overallcoma/project-grayskull/Hardware/24CHv1.0/24_channel_esp32_energy_meter.kicad_sch

## KiCad design Hardware/24CHv1.0/24_channel_esp32_energy_meter.kicad_sch (2023-05-05)

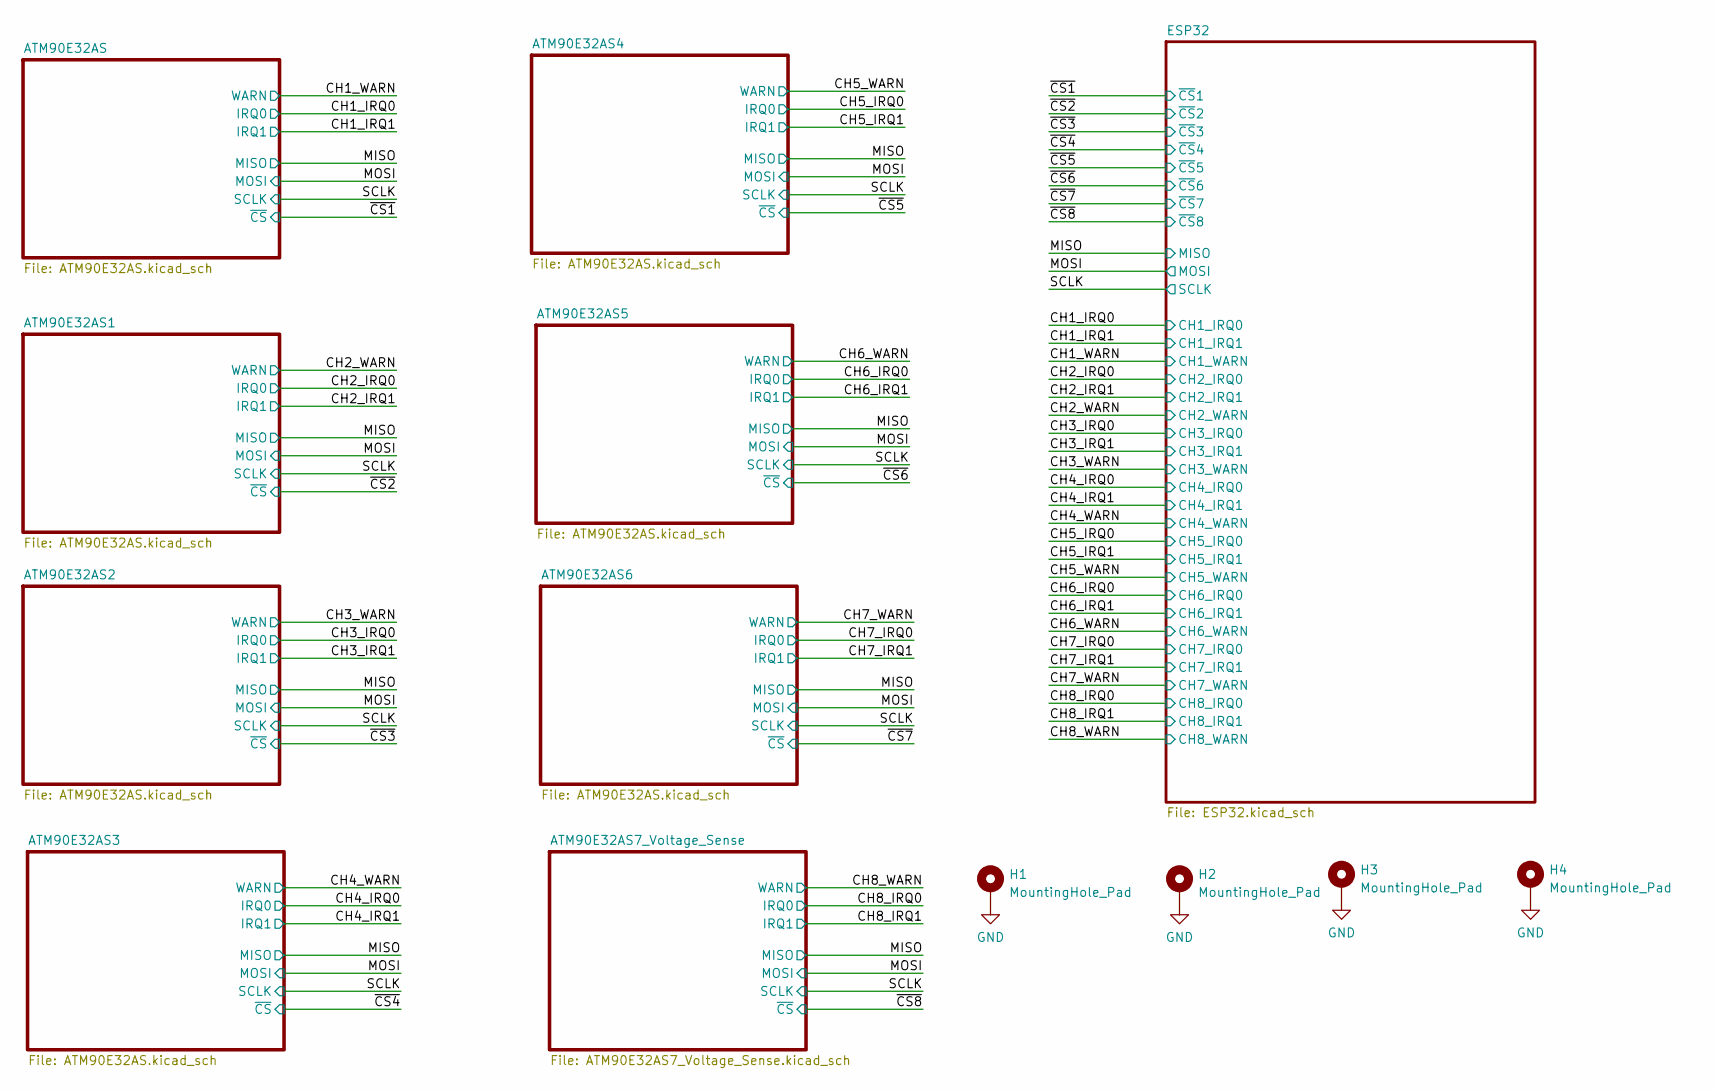
[picture p1: schematic 24_channel_esp32_energy_meter.kicad_sch]

Parts:
H1, H2, H3, H4: MountingHole_Pad; MountingHole_3.2mm_M3_Pad_Via

Connections:
GND: H1.1, H2.1, H3.1, H4.1
