overallcoma/project-grayskull/Hardware/24CHv1.0/ATM90E32AS7_Voltage_Sense.kicad_sch

## KiCad design Hardware/24CHv1.0/ATM90E32AS7_Voltage_Sense.kicad_sch (2023-05-05)

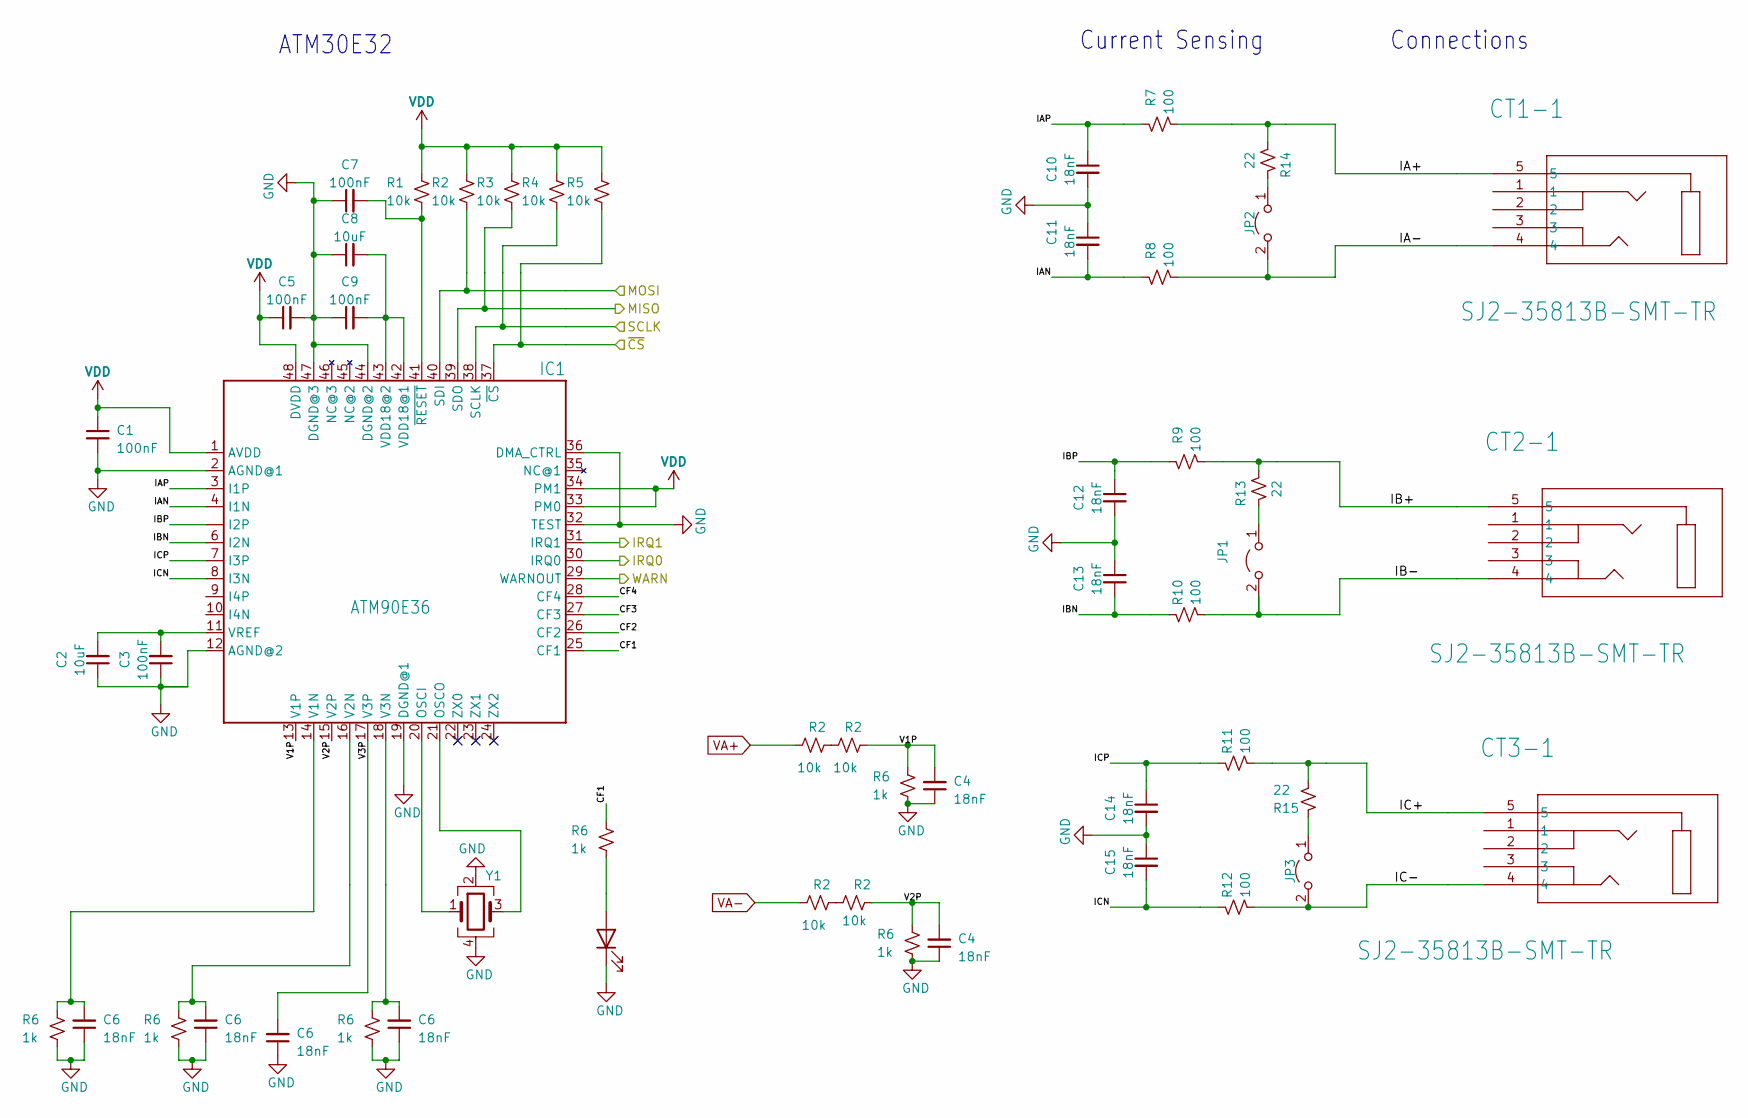
[picture p2: schematic ATM90E32AS7_Voltage_Sense.kicad_sch]

Parts:
C1, C3, C5, C7, C9: 100nF; C_0603_1608Metric; Manufacturer P/N CL10B104KB8NNWC
C2, C8: 10uF; C_0805_2012Metric; Manufacturer P/N CL21A106KAYNNNG
C4, C6, C10, C11, C12, C13, C14, C15: 18nF; C_0603_1608Metric; Manufacturer P/N 0603B183K500CT
CF1: BLU; LED_0603_1608Metric; Manufacturer P/N B1931NB--20C007614U1930
CT1-1, CT2-1, CT3-1: SJ2-35813B-SMT-TR; STX-3790-5N_KYC; Manufacturer P/N STX-3790-5N
IC1: ATM90E36; LQFP-48_7x7mm_P0.5mm; Manufacturer P/N ATM90E36A-AU-Y
JP1, JP2, JP3: Jumper_2_Open; SolderJumper-2_P1.3mm_Open_RoundedPad1.0x1.5mm
R1, R2, R3, R4, R5: 10k; R_0603_1608Metric; Manufacturer P/N RMCF0603FT10K0
R6: 1k; R_0603_1608Metric; Manufacturer P/N RMCF0603JJ1K00
R7, R8, R9, R10, R11, R12: 100; R_0603_1608Metric; Manufacturer P/N WR06X1000FTL
R13, R14, R15: 22; R_2512_6332Metric; Manufacturer P/N CR2512-JW-220ELF
Y1: Crystal_GND24; Crystal_SMD_3225-4Pin_3.2x2.5mm; Manufacturer P/N S3216384102040

Connections:
CF1: IC1.25 (CF1), R6.1
CF2: IC1.26 (CF2)
CF3: IC1.27 (CF3)
CF4: IC1.28 (CF4)
GND: C1.2, C2.1, C3.1, C4.1, C5.2, C6.1, C7.1, C8.1, C9.1, C10.2, C11.1, C12.2, C13.1, C14.2, C15.1, CF1.1 (K), IC1.2 (AGND@1), IC1.12 (AGND@2), IC1.19 (DGND@1), IC1.32 (TEST), IC1.36 (DMA_CTRL), IC1.44 (DGND@2), IC1.47 (DGND@3), R6.2, Y1.2, Y1.4
IA+: CT1-1.5, R7.2, R14.2
IA-: CT1-1.4, JP2.2 (B), R8.2
IAN: C11.2, IC1.4 (I1N), R8.1
IAP: C10.1, IC1.3 (I1P), R7.1
IB+: CT2-1.5, R9.2, R13.2
IB-: CT2-1.4, JP1.2 (B), R10.2
IBN: C13.2, IC1.6 (I2N), R10.1
IBP: C12.1, IC1.5 (I2P), R9.1
IC+: CT3-1.5, R11.2, R15.2
IC-: CT3-1.4, JP3.2 (B), R12.2
ICN: C15.2, IC1.8 (I3N), R12.1
ICP: C14.1, IC1.7 (I3P), R11.1
IRQ0: IC1.30 (IRQ0)
IRQ1: IC1.31 (IRQ1)
MISO: IC1.39 (SDO), R3.2
MOSI: IC1.40 (SDI), R2.2
unnamed: C2.2, C3.2, IC1.11 (VREF)
unnamed: C6.2, IC1.14 (V1N), IC1.16 (V2N), IC1.18 (V3N), R6.1
unnamed: C7.2, IC1.41 (~RESET), R1.2
unnamed: C8.2, C9.2, IC1.42 (VDD18@1), IC1.43 (VDD18@2)
unnamed: CF1.2 (A), R6.2
unnamed: IC1.20 (OSCI), Y1.1
unnamed: IC1.21 (OSCO), Y1.3
unnamed: JP1.1 (A), R13.1
unnamed: JP2.1 (A), R14.1
unnamed: JP3.1 (A), R15.1
unnamed: R2.1, R2.2
SCLK: IC1.38 (SCLK), R4.2
V1P: C4.2, IC1.13 (V1P), R2.2, R6.1
V2P: C4.2, IC1.15 (V2P), R2.2, R6.1
V3P: C6.2, IC1.17 (V3P)
VA+: R2.1
VA-: R2.1
VDD: C1.1, C5.1, IC1.1 (AVDD), IC1.33 (PM0), IC1.34 (PM1), IC1.48 (DVDD), R1.1, R2.1, R3.1, R4.1, R5.1
WARN: IC1.29 (WARNOUT)
~CS: IC1.37 (~CS), R5.2

Notes on the sheet:
Current Sensing
Connections
ATM30E32
