overallcoma/project-grayskull/Hardware/24CHv1.0/ESP32.kicad_sch

## KiCad design Hardware/24CHv1.0/ESP32.kicad_sch (2023-05-05)

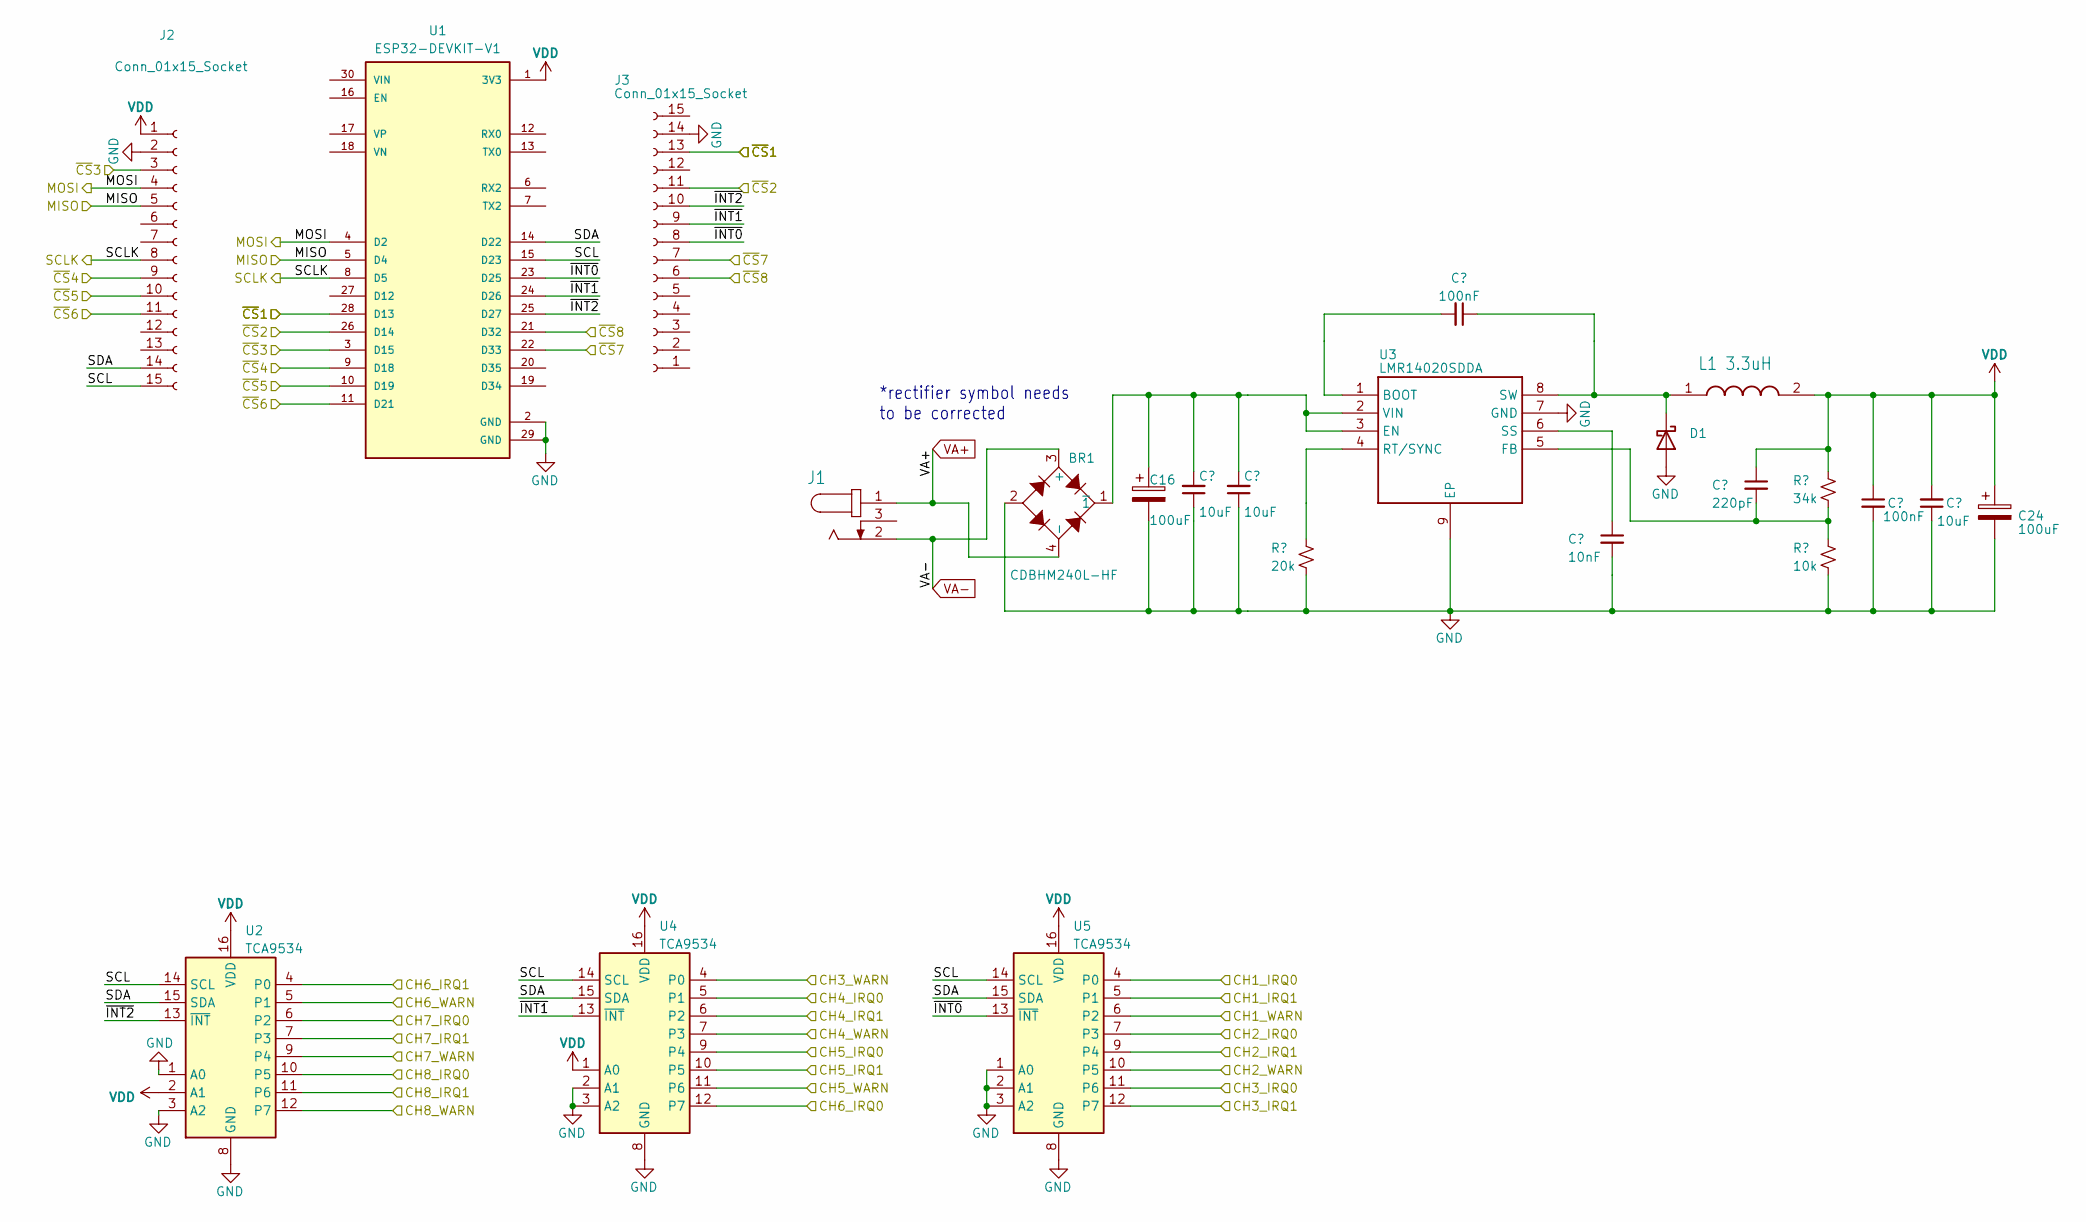
[picture p3: schematic ESP32.kicad_sch]

Parts:
BR1: CDBHM240L-HF; TO-269AA
C16, C24: 100uF; CP_Elec_6.3x9.9; Manufacturer P/N 35TZV100M6.3X8
C17, C18, C23: 10uF; C_0805_2012Metric; Manufacturer P/N CL21A106KAYNNNG
C19, C22: 100nF; C_0603_1608Metric; Manufacturer P/N CL10B104KB8NNWC
C20: 10nF; C_0603_1608Metric; Manufacturer P/N GRT1885C1E103JA02J
C21: 220pF; C_0603_1608Metric; Manufacturer P/N CL10C221JB8NNNC
D1: D_Schottky; D_SMA; Manufacturer P/N SS34A
J1: PJ-002AH-SMT-TR; BarrelJack_CLIFF_FC681465S_SMT_Horizontal; Manufacturer P/N PJ-002AH-SMT-TR
J2, J3: Conn_01x15_Socket; PinSocket_1x15_P2.54mm_Vertical; Manufacturer P/N PPTC151LFBN-RC
L1: 3.3uH; IND_TAIYO_NRS5020_TAY; Manufacturer P/N NRS5020T3R3NMGJ
R22: 20k; R_0603_1608Metric; Manufacturer P/N RC0603FR-0720KL
R23: 34k; R_0603_1608Metric; Manufacturer P/N RC0603FR-0734KL
R24: 10k; R_0603_1608Metric; Manufacturer P/N RMCF0603FT10K0
U1: ESP32-DEVKIT-V1; MODULE_ESP32_DEVKIT_V1; PARTREV N/A
U2, U4, U5: TCA9534; SSOP-16_4.4x5.2mm_P0.65mm; Manufacturer P/N TCA9534PWR
U3: LMR14020SDDA; HSOP-8-1EP_3.9x4.9mm_P1.27mm_EP2.41x3.1mm; Manufacturer P/N LMR14020SDDA

Connections:
CH1_IRQ0: U5.4 (P0)
CH1_IRQ1: U5.5 (P1)
CH1_WARN: U5.6 (P2)
CH2_IRQ0: U5.7 (P3)
CH2_IRQ1: U5.9 (P4)
CH2_WARN: U5.10 (P5)
CH3_IRQ0: U5.11 (P6)
CH3_IRQ1: U5.12 (P7)
CH3_WARN: U4.4 (P0)
CH4_IRQ0: U4.5 (P1)
CH4_IRQ1: U4.6 (P2)
CH4_WARN: U4.7 (P3)
CH5_IRQ0: U4.9 (P4)
CH5_IRQ1: U4.10 (P5)
CH5_WARN: U4.11 (P6)
CH6_IRQ0: U4.12 (P7)
CH6_IRQ1: U2.4 (P0)
CH6_WARN: U2.5 (P1)
CH7_IRQ0: U2.6 (P2)
CH7_IRQ1: U2.7 (P3)
CH7_WARN: U2.9 (P4)
CH8_IRQ0: U2.10 (P5)
CH8_IRQ1: U2.11 (P6)
CH8_WARN: U2.12 (P7)
GND: BR1.2, C16.2, C17.1, C18.1, C20.2, C22.2, C23.1, C24.2, D1.2 (A), J2.2, J3.14, R22.2, R24.2, U1.2 (GND), U1.29 (GND), U2.1 (A0), U2.3 (A2), U2.8 (GND), U3.7 (GND), U3.9 (EP), U4.2 (A1), U4.3 (A2), U4.8 (GND), U5.1 (A0), U5.2 (A1), U5.3 (A2), U5.8 (GND)
MISO: J2.5, U1.5 (D4)
MOSI: J2.4, U1.4 (D2)
unnamed: BR1.1 (~1), C16.1, C17.2, C18.2, U3.2 (VIN), U3.3 (EN)
unnamed: C19.1, D1.1 (K), L1.1, U3.8 (SW)
unnamed: C19.2, U3.1 (BOOT)
unnamed: C20.1, U3.6 (SS)
unnamed: C21.2, R23.2, R24.1, U3.5 (FB)
unnamed: R22.1, U3.4 (RT/SYNC)
SCL: J2.15, U1.15 (D23), U2.14 (SCL), U4.14 (SCL), U5.14 (SCL)
SCLK: J2.8, U1.8 (D5)
SDA: J2.14, U1.14 (D22), U2.15 (SDA), U4.15 (SDA), U5.15 (SDA)
VA+: BR1.4 (-), J1.1
VA-: BR1.3 (+), J1.2
VDD: C21.1, C22.1, C23.2, C24.1, J2.1, L1.2, R23.1, U1.1 (3V3), U2.2 (A1), U2.16 (VDD), U4.1 (A0), U4.16 (VDD), U5.16 (VDD)
~CS1: J3.13, U1.28 (D13)
~CS2: J3.11, U1.26 (D14)
~CS3: J2.3, U1.3 (D15)
~CS4: J2.9, U1.9 (D18)
~CS5: J2.10, U1.10 (D19)
~CS6: J2.11, U1.11 (D21)
~CS7: J3.7, U1.22 (D33)
~CS8: J3.6, U1.21 (D32)
~INT0: J3.8, U1.23 (D25), U5.13 (~INT)
~INT1: J3.9, U1.24 (D26), U4.13 (~INT)
~INT2: J3.10, U1.25 (D27), U2.13 (~INT)

Notes on the sheet:
*rectifier symbol needs to be corrected
