overallcoma/project-grayskull/grayskullESP/main.py

from wifi_manager import WifiManager
from mqtt import mqtt_send_loop
import time

wm = WifiManager()
if not wm.is_connected():
    wm.connect()
if wm.is_connected():
    print("Wifi is connected")

time.sleep(2)

mqtt_send_loop()
